siegfriedbruckner902/Scanner/FDORCKAI81GBZ4X.stl

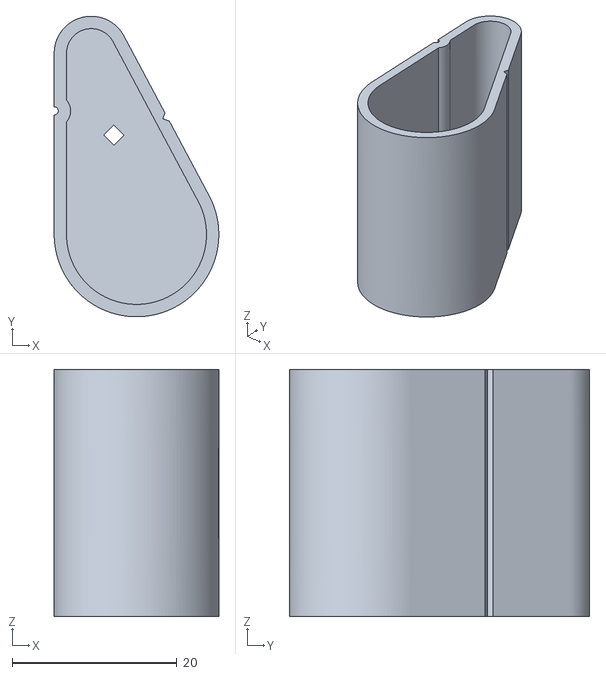
[picture p7: CAD file, 2023-04-20]
FDORCKAI81GBZ4X.stl
20.0 x 36.5 x 30.0
